PinballWizards/LED_Matrix_PCB/LED_Matrix_PCB/README.md

# pcb_solenoid_board
KiCAD PCB files for Solenoid Node Board
