PinballWizards/LED_Matrix_PCB/LED_Matrix_PCB/BOM.xlsx

Name | Description | Unit Price | Quantity | 3X Board Quantity | Total Cost per Board | Vendor | Link
TI SN65HVD72DR | TI Half-Duplex RS-485 Transceiver | $2.65 | 1 | 3 | $2.65 | Digi-key | https://www.digikey.com/product-detail/en/texas-instruments/SN65HVD72DR/296-39179-1-ND/5143186
Bournes CDSOT23-SM712 | Bournes TVS-Diode | $1.53 | 1 | 3 | $1.53 | Digi-key | https://www.digikey.com/product-detail/en/bourns-inc/CDSOT23-SM712/CDSOT23-SM712CT-ND/1630607
Adam Tech MTS-02 | CONN HOUSING 2POS 2.54MM | $0.10 | 52 | 156 | $5.20 | Digi-Key | https://www.digikey.com/product-detail/en/adam-tech/MTS-02/2057-MTS-02-ND/9830694
TE Connectivity 640456-2 | CONN HEADER VERT 2POS 2.54MM | $0.11 | 52 | 156 | $5.72 | Digi-Key | https://www.digikey.com/product-detail/en/te-connectivity-amp-connectors/640456-2/A1921-ND/109003
On Semiconductor 2N7000 | 200 mA 2Vgss Mosfet | $0.32 | 14 | 42 | $4.48 | Digi-key | https://www.digikey.com/product-detail/en/on-semiconductor/2N7000/2N7000FS-ND/244278
Adafruit 2772 | Adafruit M0+ Basic Proto | $19.95 | 1 | 3 | $19.95 | Digi-key | https://www.digikey.com/product-detail/en/adafruit-industries-llc/2772/1528-1531-ND/5775537
Stackpole Electronics RSMF2JT300R | Through Hole 300 ohm 2 watt resistor | $0.28 | 7 | 21 | $1.96 | Digi-key | https://www.digikey.com/product-detail/en/stackpole-electronics-inc/RSMF2JT300R/RSMF2JT300RCT-ND/2021864
Stackpole Electronics CF12JT10R0 | Through Hole 10 ohm ¼ watt Resistor | $0.10 | 2 | 6 | $0.20 | Digi-key | https://www.digikey.com/product-detail/en/stackpole-electronics-inc/CF12JT10R0/CF12JT10R0CT-ND/1830446
Stackpole Electronics CF14JT100R | Through Hole 100 ohm ¼ watt Resistor | $0.10 | 14 | 42 | $1.40 | Digi-key | https://www.digikey.com/product-detail/en/stackpole-electronics-inc/CF14JT100R/CF14JT100RCT-ND/1830327
Stackpole Electronics CF18JT3K00 | Through Hole 3k ohm 1/4 watt Resistor | $0.10 | 14 | 42 | $1.40 | Digi-key | https://www.digikey.com/product-detail/en/stackpole-electronics-inc/CF18JT3K00/CF18JT3K00CT-ND/2022753
Nichicon UVK2GR47MED1TD | Radial 0.1 uF Electrolytic Cap | $0.06 | 1 | 3 | $0.06 | Digi-key | https://www.digikey.com/product-detail/en/nichicon/UVK2GR47MED1TD/493-12648-3-ND/4328849
OFNMY LED Kit 500 pc | OFNMY LED Kit 500 pc | $9.99 | 0.49 | 2 | $4.90 | Digi-Key | https://www.amazon.com/OFNMY-5mm-Diode-Lights-Assortment/dp/B082VWC211
 |  |  |  |  | Total Cost per Board
 |  |  |  |  | $49.25
 |  |  |  |  | *Discount prices are available for the
 |  |  |  |  | *Components at 10, 25, 50, 100, etc.
 |  |  |  |  | *for everything but the Adafruit board
