PinballWizards/LED_Matrix_PCB/LED_Matrix_PCB/solenoid_board.kicad_pcb

## KiCad design LED_Matrix_PCB/solenoid_board.kicad_pcb (2020-04-11)

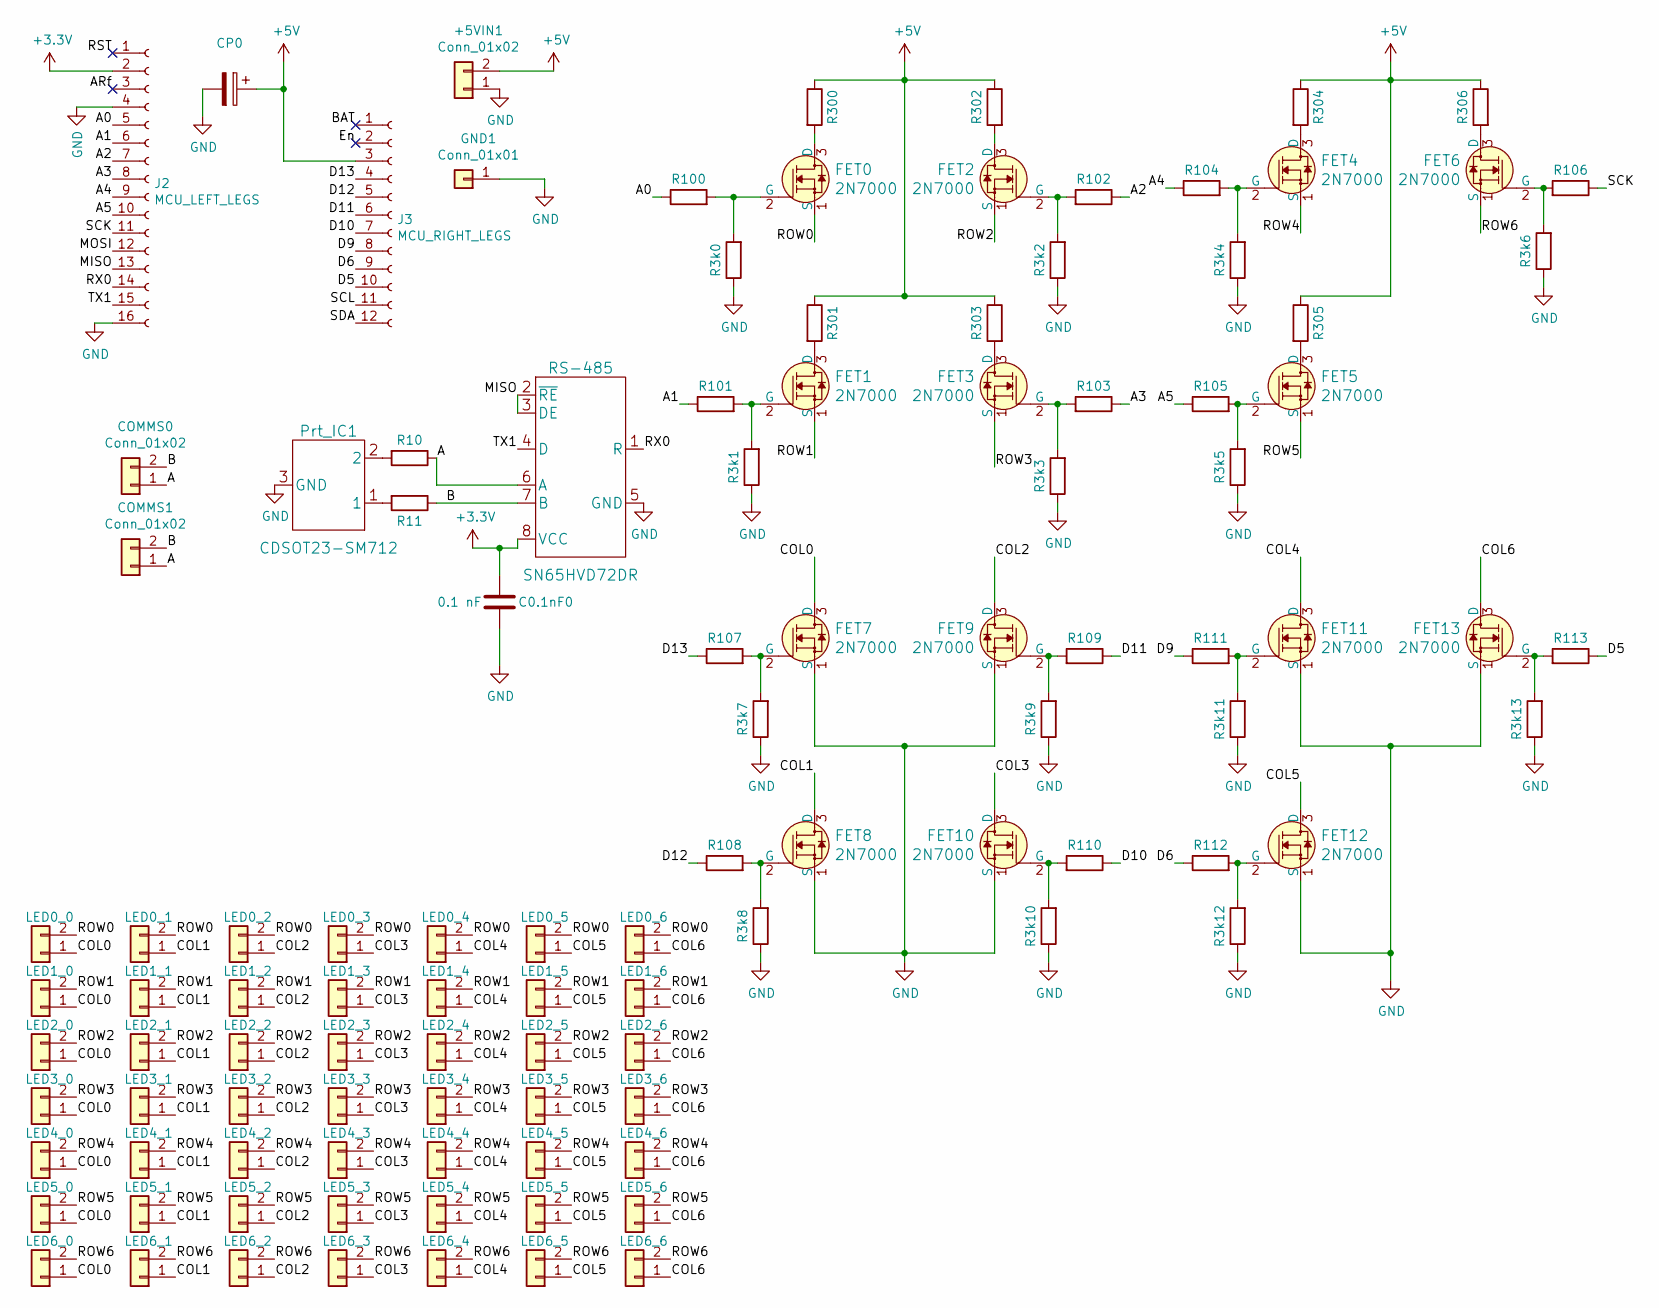
[picture p1: schematic solenoid_board.sch, Solenoid Board]

Parts:
+5VIN1: Conn_01x02; PinHeader_1x02_P2.54mm_Vertical
C0.1nF0: 0.1 nF; CP_Radial_D4.0mm_P2.00mm
COMMS0, COMMS1: Conn_01x02; PinHeader_1x02_P2.54mm_Vertical
CP0: CP; CP_Radial_D5.0mm_P2.50mm
FET0, FET1, FET2, FET3, FET4, FET5, FET6, FET7, FET8, FET9, FET10, FET11, FET12, FET13: 2N7000; TO-92-3; MPN 2N7000; Digi-Key_PN 2N7000FS-ND
GND1: Conn_01x01; PinHeader_1x01_P2.54mm_Vertical
J2: MCU_LEFT_LEGS; PinHeader_1x16_P2.54mm_Vertical
J3: MCU_RIGHT_LEGS; PinHeader_1x12_P2.54mm_Vertical
LED0_0, LED0_1, LED0_2, LED0_3, LED0_4, LED0_5, LED0_6, LED1_0, LED1_1, LED1_2, LED1_3, LED1_4, LED1_5, LED1_6, LED2_0, LED2_1, LED2_2, LED2_3, LED2_4, LED2_5, LED2_6, LED3_0, LED3_1, LED3_2, LED3_3, LED3_4, LED3_5, LED3_6, LED4_0, LED4_1, LED4_2, LED4_3, LED4_4, LED4_5, LED4_6, LED5_0, LED5_1, LED5_2, LED5_3, LED5_4, LED5_5, LED5_6, LED6_0, LED6_1, LED6_2, LED6_3, LED6_4, LED6_5, LED6_6: Conn_01x02; PinHeader_1x02_P2.54mm_Vertical
Prt_IC1: CDSOT23-SM712
R3k0, R3k1, R3k2, R3k3, R3k4, R3k5, R3k6, R3k7, R3k8, R3k9, R3k10, R3k11, R3k12, R3k13: 3k; R_Axial_DIN0204_L3.6mm_D1.6mm_P5.08mm_Vertical
R10, R11: 10; R_Axial_DIN0204_L3.6mm_D1.6mm_P7.62mm_Horizontal
R100, R102, R103, R104, R105, R106, R107, R108, R109, R110, R111, R112, R113: 100; R_Axial_DIN0204_L3.6mm_D1.6mm_P5.08mm_Vertical
R101: 10; R_Axial_DIN0204_L3.6mm_D1.6mm_P5.08mm_Vertical
R300, R301, R302, R303, R304, R305, R306: 300; R_Axial_DIN0204_L3.6mm_D1.6mm_P5.08mm_Vertical
RS-485: SN65HVD72DR

Connections:
+3V3: C0.1nF0.2, J2.2, RS-485.8 (VCC)
+5V: +5VIN1.2, CP0.1, J3.3, R300.1, R301.1, R302.1, R303.1, R304.1, R305.1, R306.1
/A: COMMS0.1, COMMS1.1, R10.1, RS-485.6 (A)
/A0: J2.5, R100.1
/A1: J2.6, R101.1
/A2: J2.7, R102.1
/A3: J2.8, R103.1
/A4: J2.9, R104.1
/A5: J2.10, R105.1
/ARf: J2.3
/B: COMMS0.2, COMMS1.2, R11.1, RS-485.7 (B)
/BAT: J3.1
/COL0: FET7.3 (D), LED0_0.1, LED1_0.1, LED2_0.1, LED3_0.1, LED4_0.1, LED5_0.1, LED6_0.1
/COL1: FET8.3 (D), LED0_1.1, LED1_1.1, LED2_1.1, LED3_1.1, LED4_1.1, LED5_1.1, LED6_1.1
/COL2: FET9.3 (D), LED0_2.1, LED1_2.1, LED2_2.1, LED3_2.1, LED4_2.1, LED5_2.1, LED6_2.1
/COL3: FET10.3 (D), LED0_3.1, LED1_3.1, LED2_3.1, LED3_3.1, LED4_3.1, LED5_3.1, LED6_3.1
/COL4: FET11.3 (D), LED0_4.1, LED1_4.1, LED2_4.1, LED3_4.1, LED4_4.1, LED5_4.1, LED6_4.1
/COL5: FET12.3 (D), LED0_5.1, LED1_5.1, LED2_5.1, LED3_5.1, LED4_5.1, LED5_5.1, LED6_5.1
/COL6: FET13.3 (D), LED0_6.1, LED1_6.1, LED2_6.1, LED3_6.1, LED4_6.1, LED5_6.1, LED6_6.1
/D5: J3.10, R113.1
/D6: J3.9, R112.1
/D9: J3.8, R111.1
/D10: J3.7, R110.1
/D11: J3.6, R109.1
/D12: J3.5, R108.1
/D13: J3.4, R107.1
/En: J3.2
/MISO: J2.13, RS-485.2 (~RE~), RS-485.3 (DE)
/MOSI: J2.12
/ROW0: FET0.1 (S), LED0_0.2, LED0_1.2, LED0_2.2, LED0_3.2, LED0_4.2, LED0_5.2, LED0_6.2
/ROW1: FET1.1 (S), LED1_0.2, LED1_1.2, LED1_2.2, LED1_3.2, LED1_4.2, LED1_5.2, LED1_6.2
/ROW2: FET2.1 (S), LED2_0.2, LED2_1.2, LED2_2.2, LED2_3.2, LED2_4.2, LED2_5.2, LED2_6.2
/ROW3: FET3.1 (S), LED3_0.2, LED3_1.2, LED3_2.2, LED3_3.2, LED3_4.2, LED3_5.2, LED3_6.2
/ROW4: FET4.1 (S), LED4_0.2, LED4_1.2, LED4_2.2, LED4_3.2, LED4_4.2, LED4_5.2, LED4_6.2
/ROW5: FET5.1 (S), LED5_0.2, LED5_1.2, LED5_2.2, LED5_3.2, LED5_4.2, LED5_5.2, LED5_6.2
/ROW6: FET6.1 (S), LED6_0.2, LED6_1.2, LED6_2.2, LED6_3.2, LED6_4.2, LED6_5.2, LED6_6.2
/RST: J2.1
/RX0: J2.14, RS-485.1 (R)
/SCK: J2.11, R106.1
/SCL: J3.11
/SDA: J3.12
/TX1: J2.15, RS-485.4 (D)
GND: +5VIN1.1, C0.1nF0.1, CP0.2, FET7.1 (S), FET8.1 (S), FET9.1 (S), FET10.1 (S), FET11.1 (S), FET12.1 (S), FET13.1 (S), GND1.1, J2.4, J2.16, Prt_IC1.3 (GND), R3k0.1, R3k1.1, R3k2.1, R3k3.1, R3k4.1, R3k5.1, R3k6.1, R3k7.1, R3k8.1, R3k9.1, R3k10.1, R3k11.1, R3k12.1, R3k13.1, RS-485.5 (GND)
unnamed: FET0.2 (G), R3k0.2, R100.2
unnamed: FET0.3 (D), R300.2
unnamed: FET1.2 (G), R3k1.2, R101.2
unnamed: FET1.3 (D), R301.2
unnamed: FET2.2 (G), R3k2.2, R102.2
unnamed: FET2.3 (D), R302.2
unnamed: FET3.2 (G), R3k3.2, R103.2
unnamed: FET3.3 (D), R303.2
unnamed: FET4.2 (G), R3k4.2, R104.2
unnamed: FET4.3 (D), R304.2
unnamed: FET5.2 (G), R3k5.2, R105.2
unnamed: FET5.3 (D), R305.2
unnamed: FET6.2 (G), R3k6.2, R106.2
unnamed: FET6.3 (D), R306.2
unnamed: FET7.2 (G), R3k7.2, R107.2
unnamed: FET8.2 (G), R3k8.2, R108.2
unnamed: FET9.2 (G), R3k9.2, R109.2
unnamed: FET10.2 (G), R3k10.2, R110.2
unnamed: FET11.2 (G), R3k11.2, R111.2
unnamed: FET12.2 (G), R3k12.2, R112.2
unnamed: FET13.2 (G), R3k13.2, R113.2
unnamed: Prt_IC1.1, R11.2
unnamed: Prt_IC1.2, R10.2

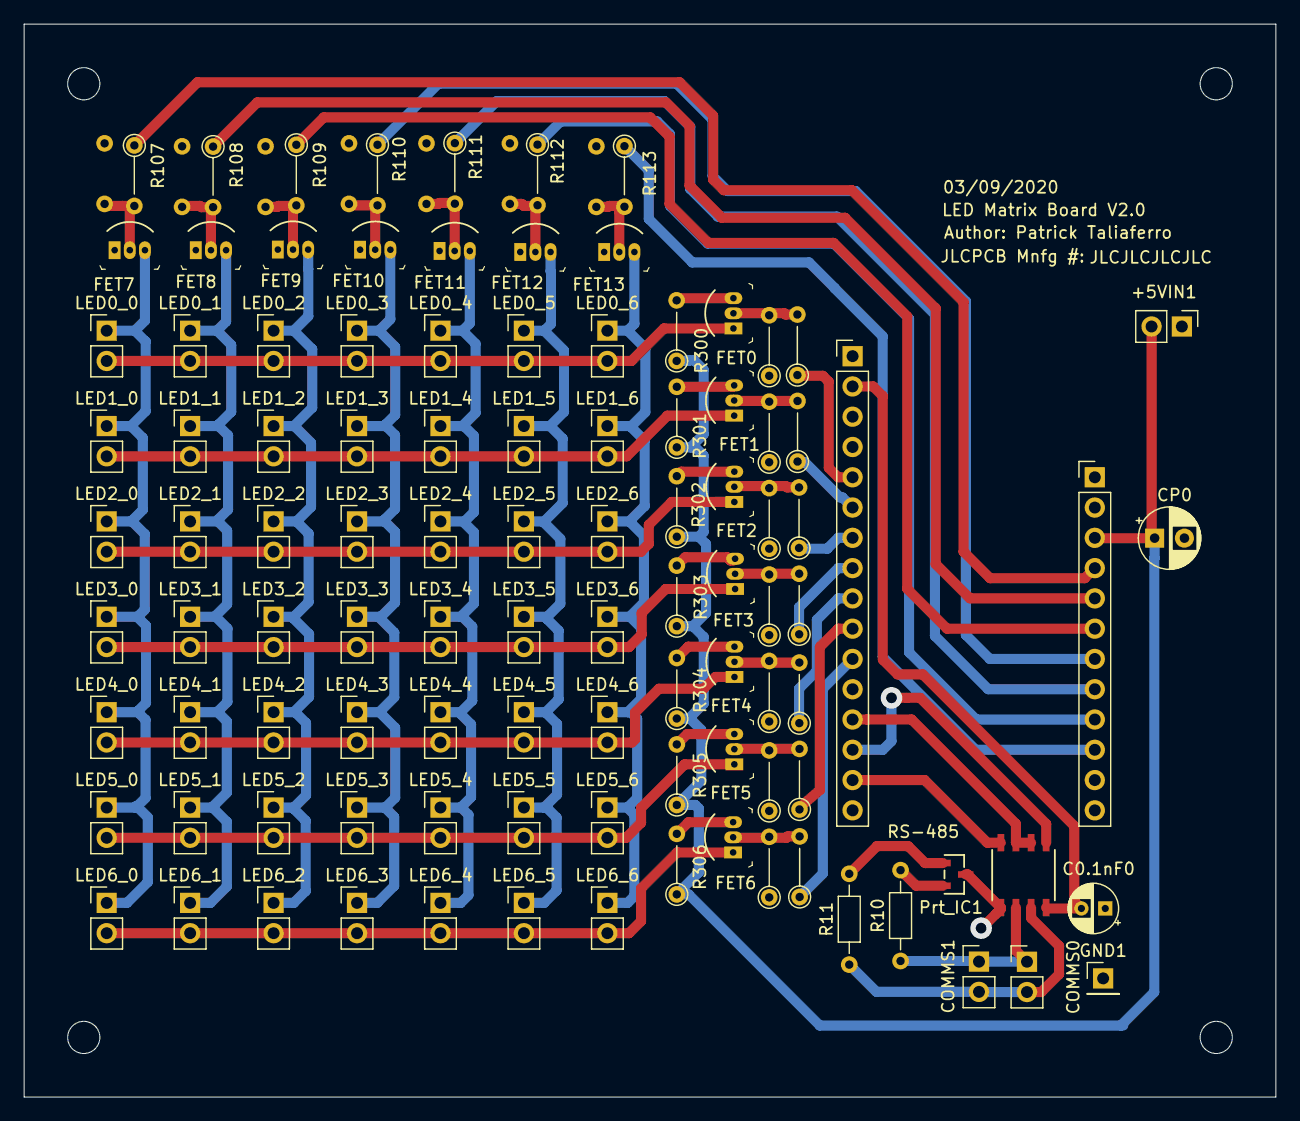
[picture p2: board solenoid_board.kicad_pcb from above]

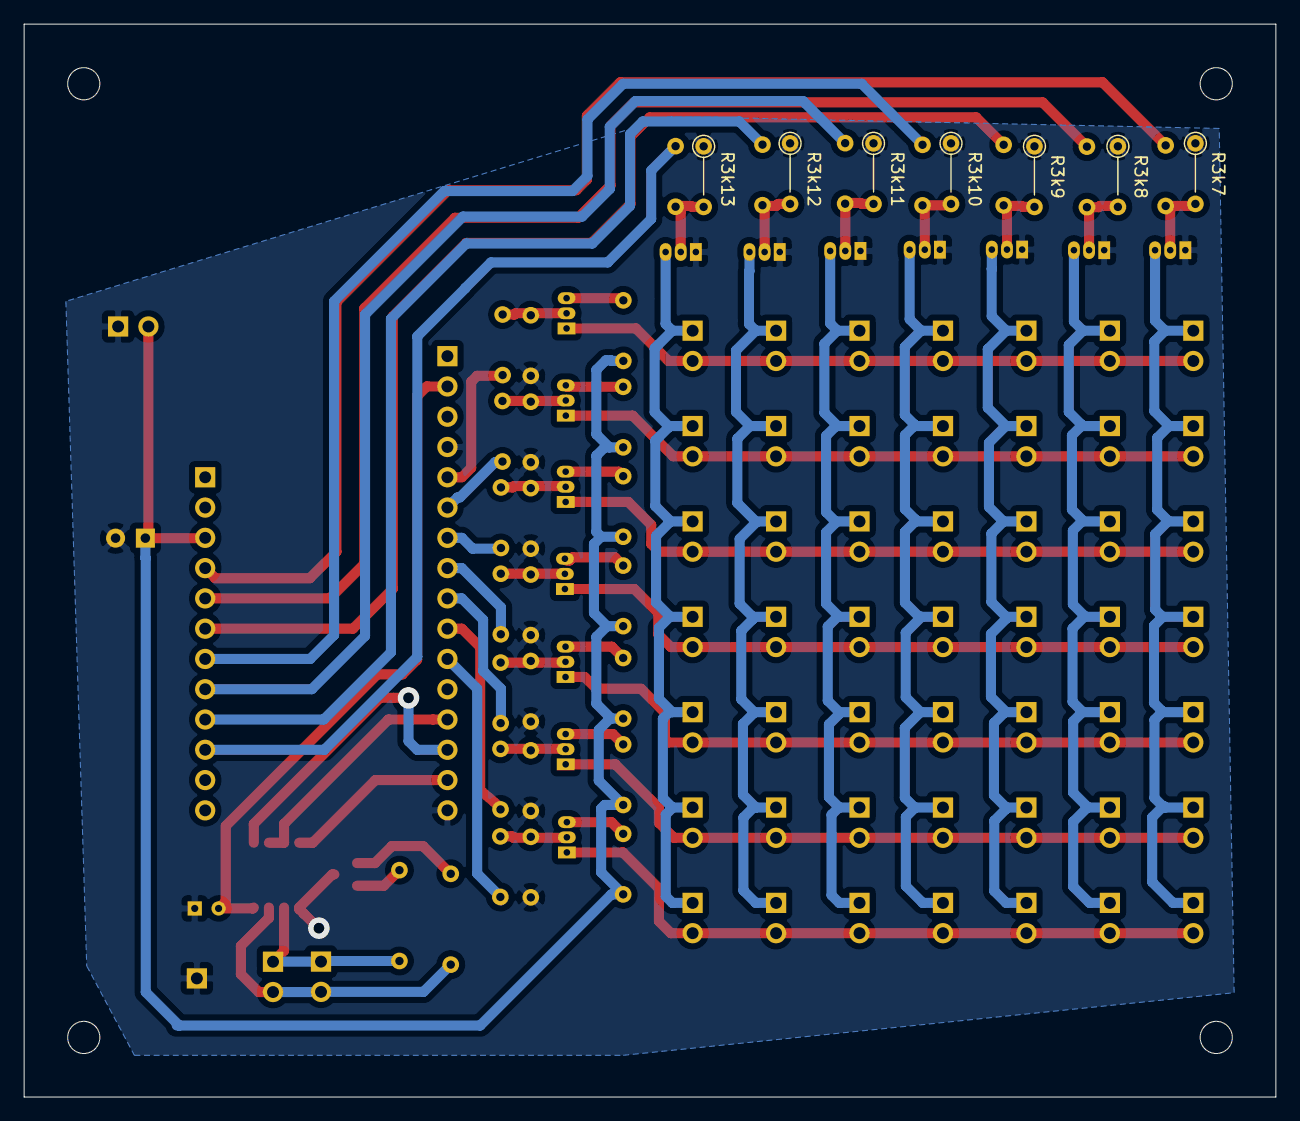
[picture p3: board solenoid_board.kicad_pcb from below]

Board: 2 copper layers, 105.0 x 90.0 mm, 110 parts (7 on the bottom side), 59 nets.
