PinballWizards/LED_Matrix_PCB/(commit log)

2020-02-07 Placed the MCU and 5V input terminal on the schematic. Need to change the footprint on the pin headers to match that of the solenoid board's MCU.
    [LED_Matrix_PCB.kicad_pcb, LED_Matrix_PCB.sch]
2020-02-07 Imported the solenoid board schematic and pcb layout and then erased application specifics. Added 81 1x2 terminal connections for a 9x9 LED Matrix with 1 330 ohm resistor on each column pin. The pcb 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
    [BOM.xlsx, LED_Matrix_PCB.kicad_pcb, LED_Matrix_PCB.sch, solenoid_board.kicad_pcb, solenoid_board.sch]
2020-02-09 Laid footprint geometry. Need to add a capacitor on the RS-485 Transciever.
    [solenoid_board.kicad_pcb]
2020-02-09 Routed 90% of wires, still need to re-order the column pin masking to better complement the routing.
    [solenoid_board.kicad_pcb, solenoid_board.sch]
2020-02-09 Placed finishing touches on V1.0
    [solenoid_board-B_Cu.gbr, solenoid_board-B_Mask.gbr, solenoid_board-B_SilkS.gbr, solenoid_board-Edge_Cuts.gbr, solenoid_board-F_Cu.gbr, solenoid_board-F_Mask.gbr, solenoid_board-F_SilkS.gbr, solenoid_board-NPTH.drl]
2020-02-09 Finished BOM
    [BOM.xlsx]
2020-02-11 Updated hyperlink, shave 50% off the per-board price by changing 2-pin terminal block suppliers.
    [BOM.xlsx]
2020-02-11 Changed footprints for resistors, changed resistor suppliers, and re-routed wires. Need to add mounting holes and clean for ordering.
    [BOM.xlsx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]
2020-02-13 Updated the .gbr files.
    [solenoid_board-B_Cu.gbr, solenoid_board-B_Mask.gbr, solenoid_board-B_SilkS.gbr, solenoid_board-Edge_Cuts.gbr, solenoid_board-F_Cu.gbr, solenoid_board-F_Mask.gbr, solenoid_board-F_SilkS.gbr, solenoid_board-NPTH.drl]
2020-02-13 Added Mounting Holes
    [solenoid_board-B_Cu.gbr, solenoid_board-B_Mask.gbr, solenoid_board-B_SilkS.gbr, solenoid_board-Edge_Cuts.gbr, solenoid_board-F_Cu.gbr, solenoid_board-F_Mask.gbr, solenoid_board-F_SilkS.gbr, solenoid_board-NPTH.drl]
2020-02-22 Changed BOM significantly. Need to swap out screw terminals for 7x7 2-pin headers on schematic. Need to change geometry of the board. Need to change Resistor Footprint. May want to start a new projec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
    [BOM.xlsx]
2020-02-23 Forgot to close files before pushing.
    [BOM.xlsx, solenoid_board.kicad_pcb, solenoid_board.sch]
2020-02-23 Fixed the connections of the downstream MOSFETS. WOrked on geometry, sorted out footprints.
    [solenoid_board.kicad_pcb, solenoid_board.sch]
2020-02-23 Cleaned geometry on layout. Routed a number of wires. Only a little bit of routing left.
    [solenoid_board.kicad_pcb]
2020-02-24 Finished routing. Done. Ready to be merged. V2 Complete.
    [solenoid_board-B_Cu.gbr, solenoid_board-B_Mask.gbr, solenoid_board-B_SilkS.gbr, solenoid_board-Edge_Cuts.gbr, solenoid_board-F_Cu.gbr, solenoid_board-F_Mask.gbr, solenoid_board-F_SilkS.gbr, solenoid_board-NPTH.drl]
2020-02-25 Moved Silk Screen and other
    [solenoid_board-B_Cu.gbr, solenoid_board-B_Mask.gbr, solenoid_board-B_SilkS.gbr, solenoid_board-Edge_Cuts.gbr, solenoid_board-F_Cu.gbr, solenoid_board-F_Mask.gbr, solenoid_board-F_SilkS.gbr, solenoid_board-NPTH.drl]
2020-02-25 Changed mosfet circuitry.
    [BOM.xlsx, solenoid_board.kicad_pcb, solenoid_board.sch]
2020-03-09 Added a pull down resistor and re-routed. Also, updated BOM.
    [BOM.xlsx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]
